test-gh-syncer2/Soldered-Temperature-and-humidity-sensor-SHTC3-breakout-hardware-design/OUTPUTS/V1.1.1/SHTC3_breakout_3D.step

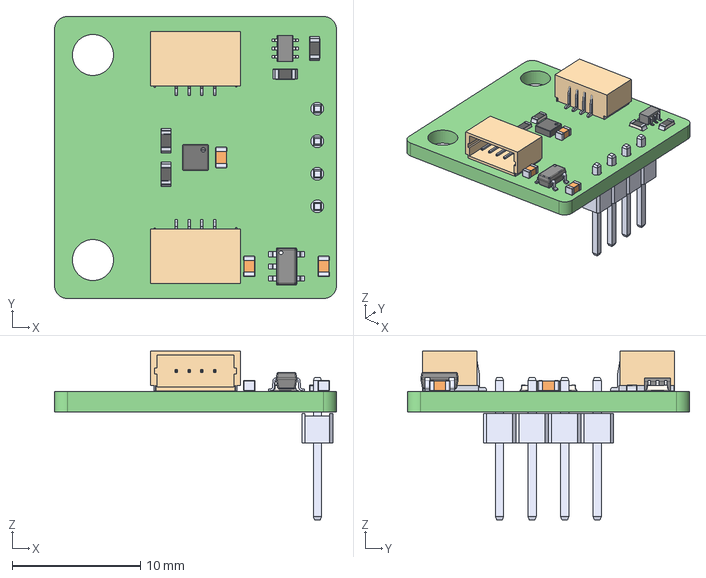
[picture p1: CAD file, 2021-09-23]
OUTPUTS/V1.1.1/SHTC3_breakout_3D.step
22.0 x 22.0 x 13.1 mm
