test-gh-syncer2/Soldered-Temperature-and-humidity-sensor-SHTC3-breakout-hardware-design/OUTPUTS/V1.1.1/SHTC3_breakout.pdf

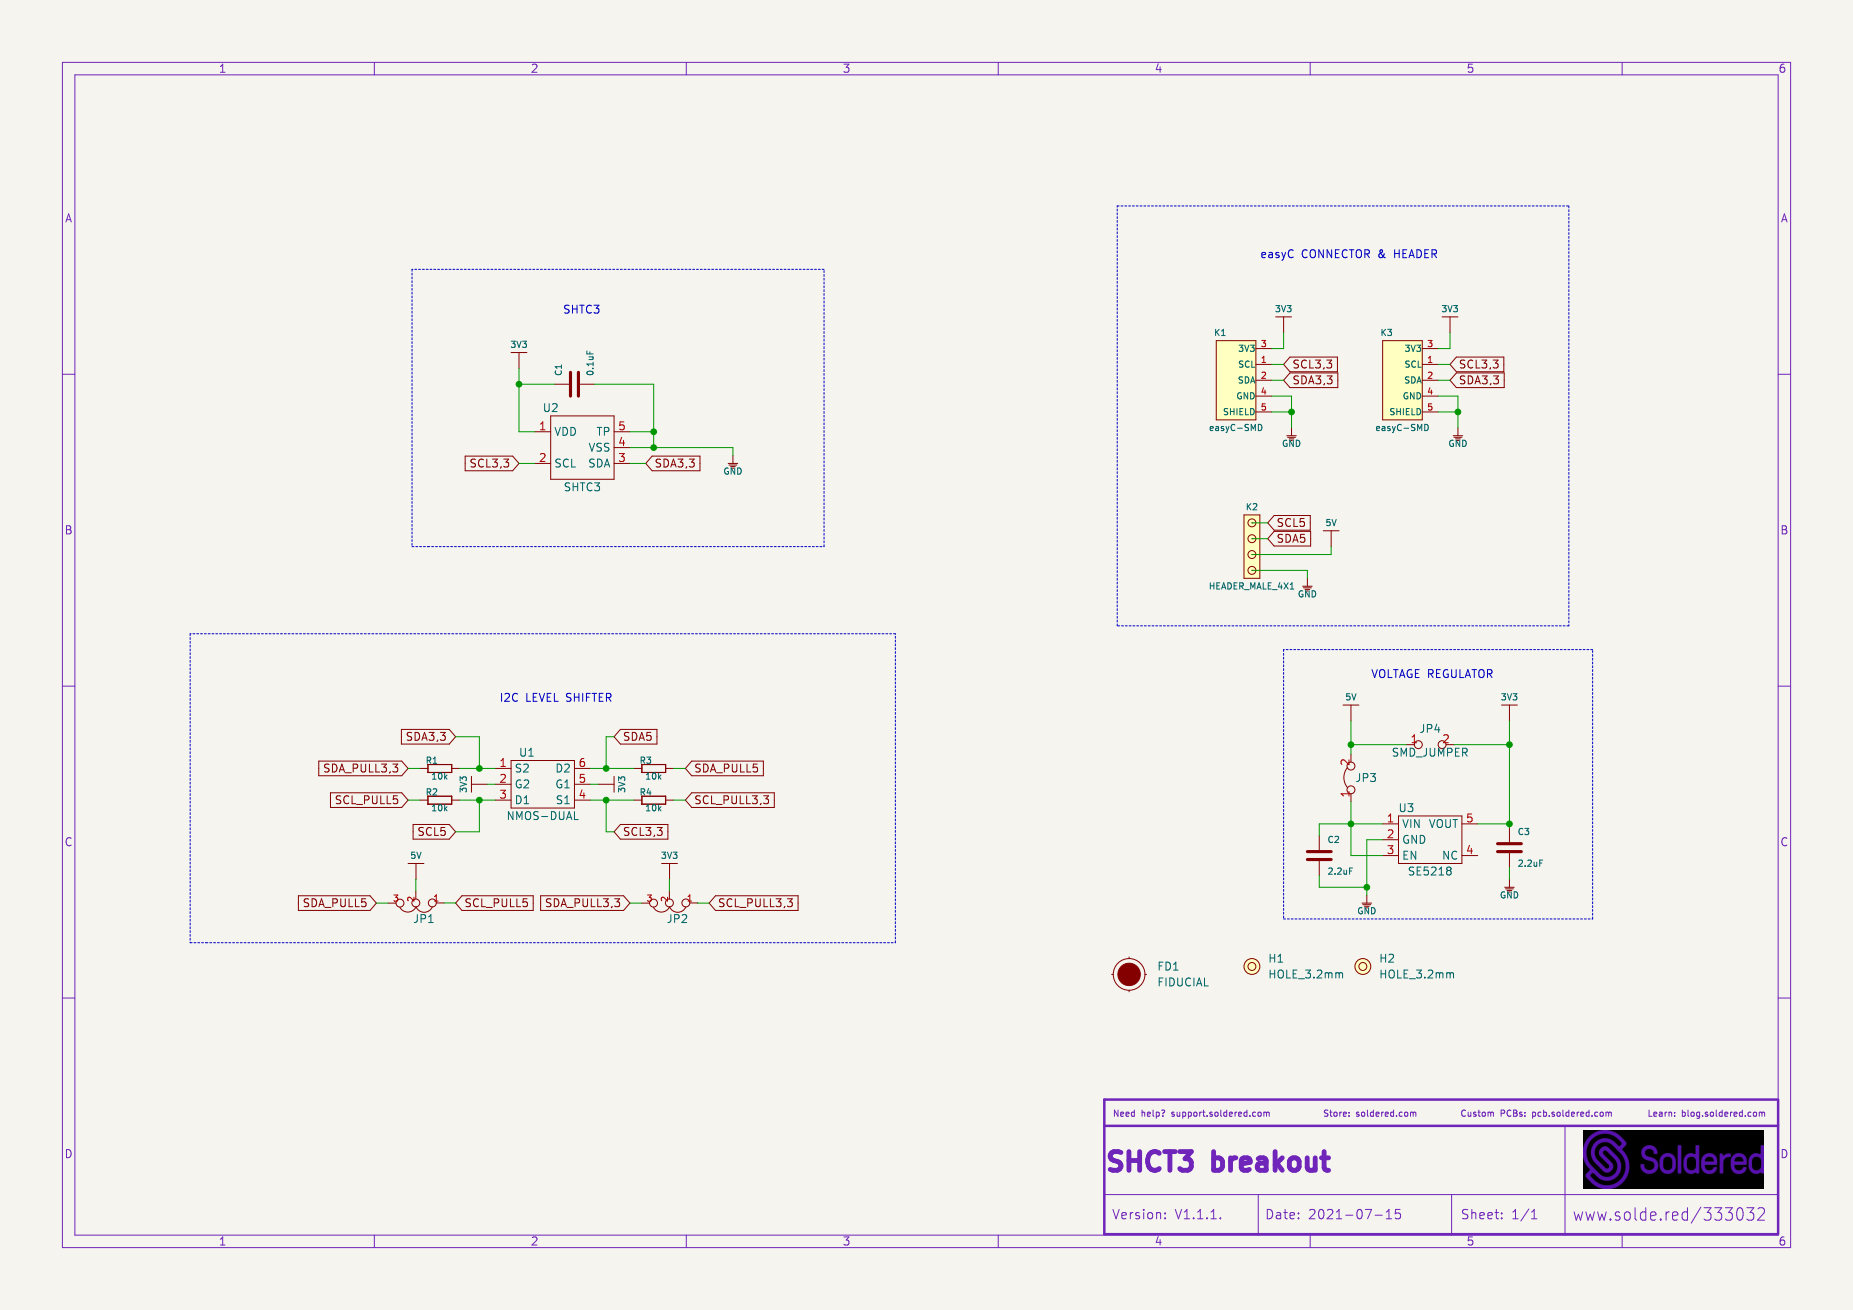
[picture p2: page 1]
