test-gh-syncer2/Soldered-Temperature-and-humidity-sensor-SHTC3-breakout-hardware-design/OUTPUTS/V1.0.0/SHTC3_breakout_schematics.pdf

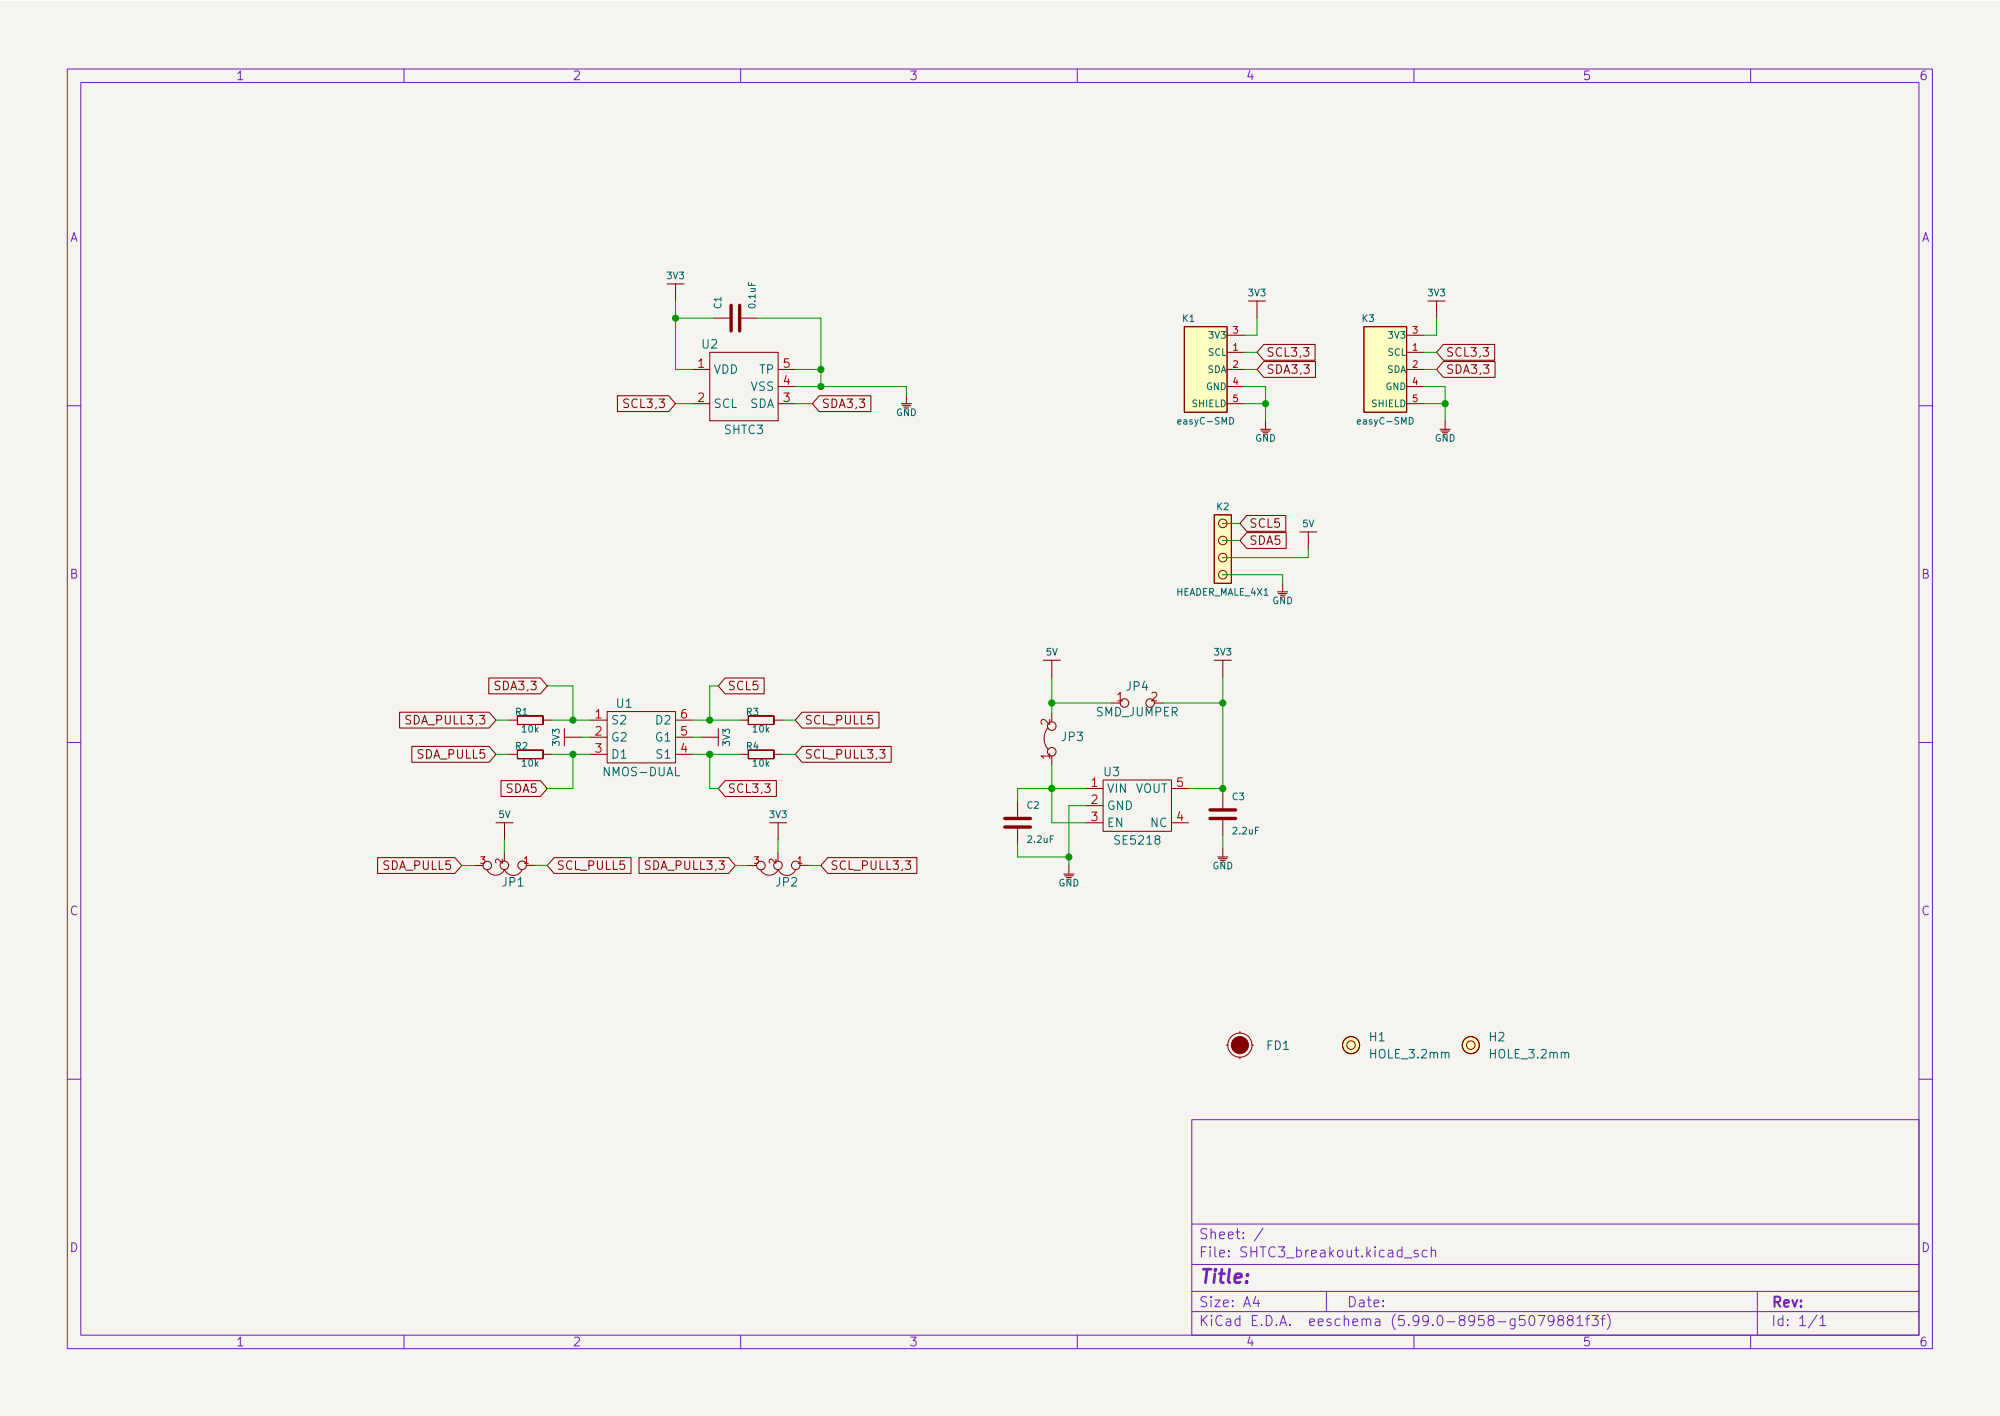
[picture p3: page 1]
