test-gh-syncer2/Soldered-Temperature-and-humidity-sensor-SHTC3-breakout-hardware-design/CAD/V1.0.0/SHTC3_breakout.kicad_pcb

## KiCad design CAD/V1.0.0/SHTC3_breakout.kicad_pcb (2021-09-23, an earlier design)

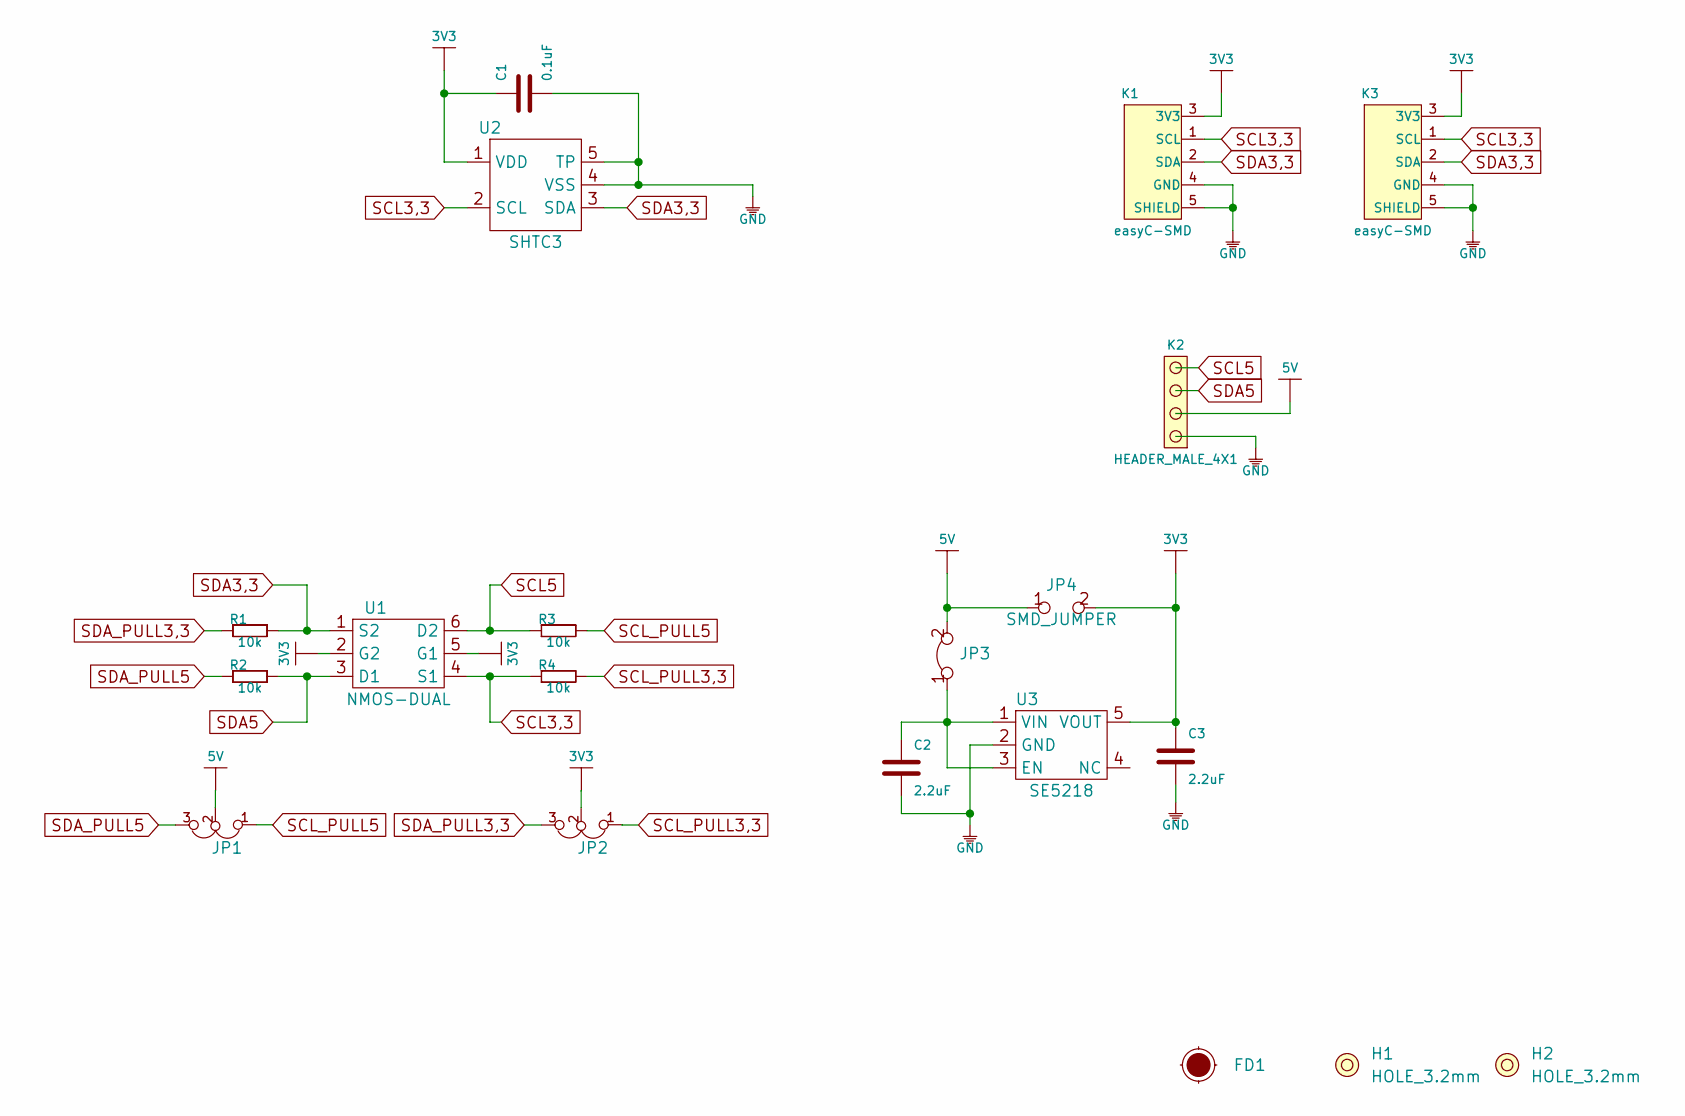
[picture p4: schematic SHTC3_breakout.kicad_sch]

Parts:
C1: 0.1uF; 0603C
C2, C3: 2.2uF; 0603C
FD1: Fiducial_Stencil; FIDUCIAL_1MM_PASTE
H1, H2: HOLE_3.2mm
JP1, JP2: SMD_JUMPER_3_PAD_TRACE
JP3: SMD-JUMPER-CONNECTED_TRACE_NOSLODERMASK
JP4: SMD_JUMPER
K1, K3: easyC-SMD; easyC-connector
K2: HEADER_MALE_4X1
R1, R2, R3, R4: 10k; 0603R
U1: NMOS-DUAL; SOT-363
U2: SHTC3
U3: SE5218; SOT-23-5

Connections:
3V3: C1.2, C3.2, JP2.2, JP4.2, K1.3 (3V3), K3.3 (3V3), U1.2 (G2), U1.5 (G1), U2.1 (VDD), U3.5 (VOUT)
5V: JP1.2, JP3.2, JP4.1, K2.2
GND: C1.1, C2.1, C3.1, K1.4 (GND), K1.5 (SHIELD), K2.1, K3.4 (GND), K3.5 (SHIELD), U2.4 (VSS), U2.5 (TP), U3.2 (GND)
unnamed: C2.2, JP3.1, U3.1 (VIN), U3.3 (EN)
SCL3,3: K1.1 (SCL), K3.1 (SCL), R4.1, U1.4 (S1), U2.2 (SCL)
SCL5: K2.4, R3.1, U1.6 (D2)
SCL_PULL3,3: JP2.1, R4.2
SCL_PULL5: JP1.1, R3.2
SDA3,3: K1.2 (SDA), K3.2 (SDA), R1.2, U1.1 (S2), U2.3 (SDA)
SDA5: K2.3, R2.2, U1.3 (D1)
SDA_PULL3,3: JP2.3, R1.1
SDA_PULL5: JP1.3, R2.1

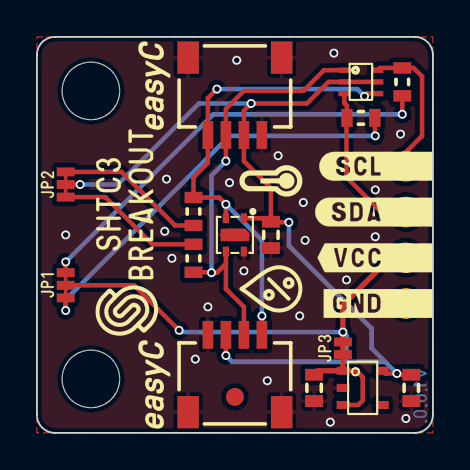
[picture p5: board SHTC3_breakout.kicad_pcb from above]

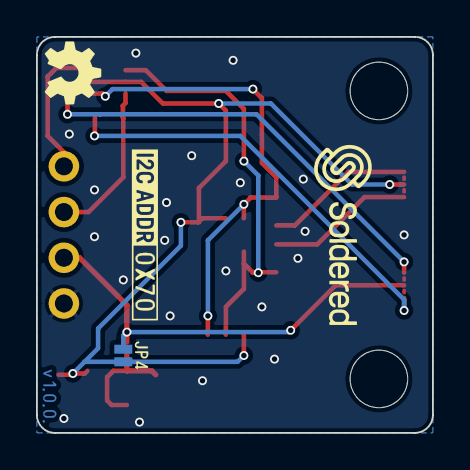
[picture p6: board SHTC3_breakout.kicad_pcb from below]

Board: 2 copper layers, 22.0 x 22.0 mm, 20 parts (2 on the bottom side), 12 nets.
