test-gh-syncer2/Soldered-Temperature-and-humidity-sensor-SHTC3-breakout-hardware-design/CAD/Change Log.xlsx

CHANGE LOG
 | Latest version |  |  | v1.1.1.
 |  | Product name: |  | SHTC3 breakout
 |  | Release date: |  | 15.7.2021.
 |  | Release author: |  | Ivan
Version: | v1.0.0. | Author: | Ivan | Date: | 9.4.2021.
List of Changes
 | Initial document
Version: | v1.1.1. | Author: | Ivan | Date: | 15.7.2021.
List of Changes
 | Stavljen novi fiducial
 | Povećane oznake jumpera
 | Jumperi malo pomaknuti od ruba da stanu oznake
 | stavljen jumper JP3 sa soldermaskom
 | Ispravljeno SDA i SCL na 5V DUAL_MOSFET bilo je zamijenjeno
 | Popravljen footprint za SE5218 - veći padovi
 | Popravljen footprint za SHTC3- oznaka prvog pina
 | Stavljen veći logo BACK
