test-gh-syncer2/Soldered-Temperature-and-humidity-sensor-SHTC3-breakout-hardware-design/(commit log)

2021-09-23 Syncing to git
    [Change Log.xlsx, SHTC3_breakout.kicad_pcb, SHTC3_breakout.kicad_sch, SHTC3_breakout_3D.step, SHTC3_breakout_BOM.csv]
2021-09-23 Updating open source files.
    [Change Log.xlsx, SHTC3_breakout.kicad_pcb, SHTC3_breakout.kicad_sch, SHTC3_breakout_3D.step, SHTC3_breakout_BOM.csv]
